Romultra/pcb-robotic-hand/docs/media/board/board_angled2.jpg

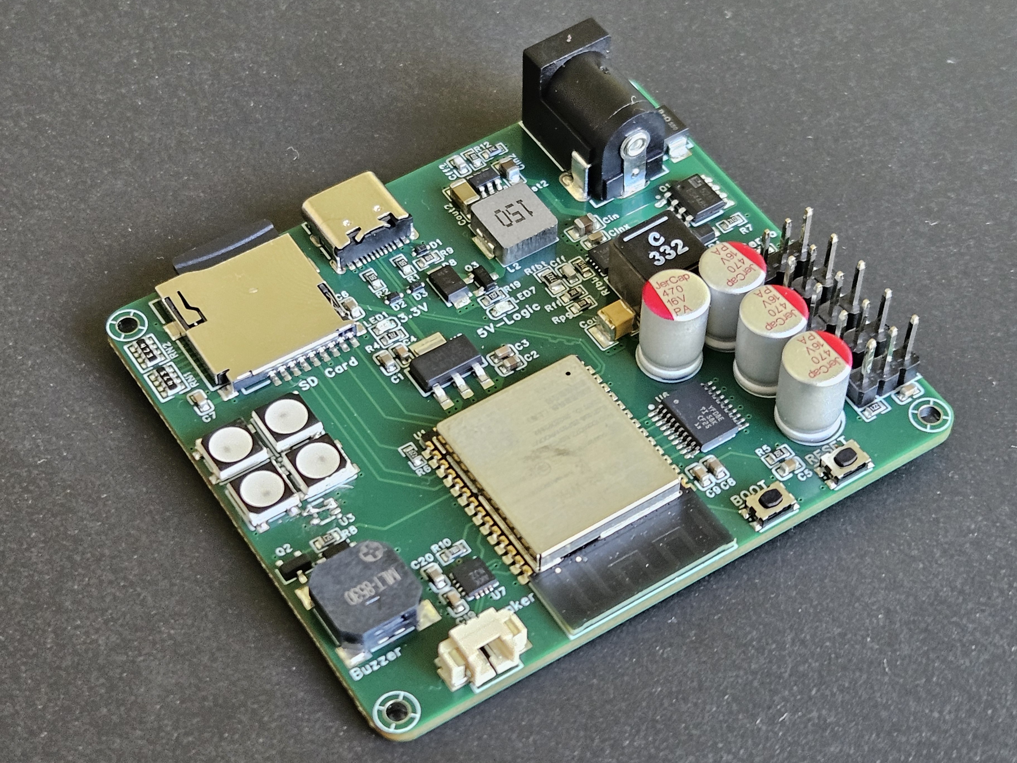
docs/media/board/board_angled2.jpg
