Romultra/pcb-robotic-hand/docs/media/board/board_scale.jpg

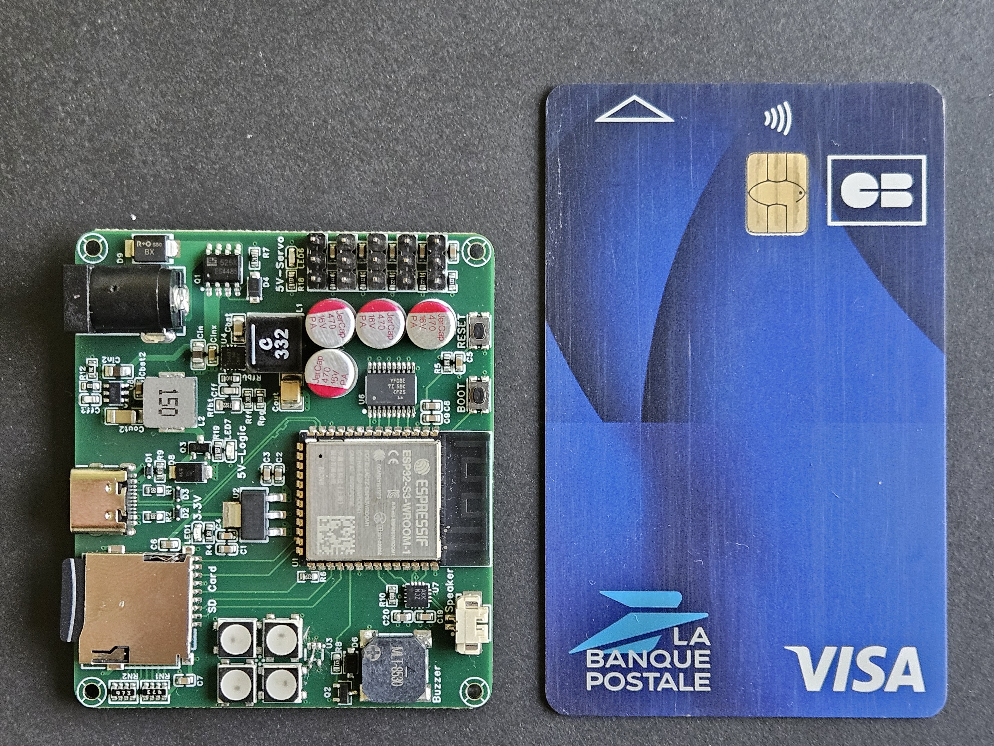
docs/media/board/board_scale.jpg
