Romultra/pcb-robotic-hand/docs/media/board/board_topdown.jpg

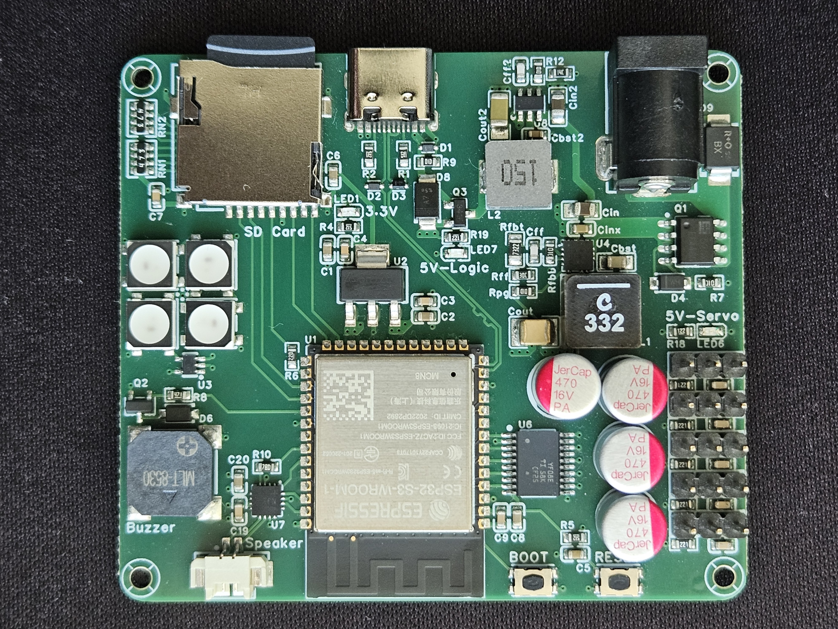
docs/media/board/board_topdown.jpg
