Romultra/pcb-robotic-hand/docs/media/demo/end_to_end_inset.jpg

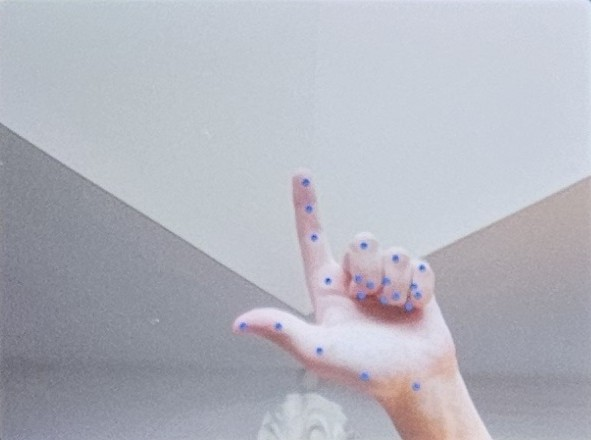
docs/media/demo/end_to_end_inset.jpg
