Romultra/pcb-robotic-hand/docs/media/prototype/prototype_arduino_shield.jpg

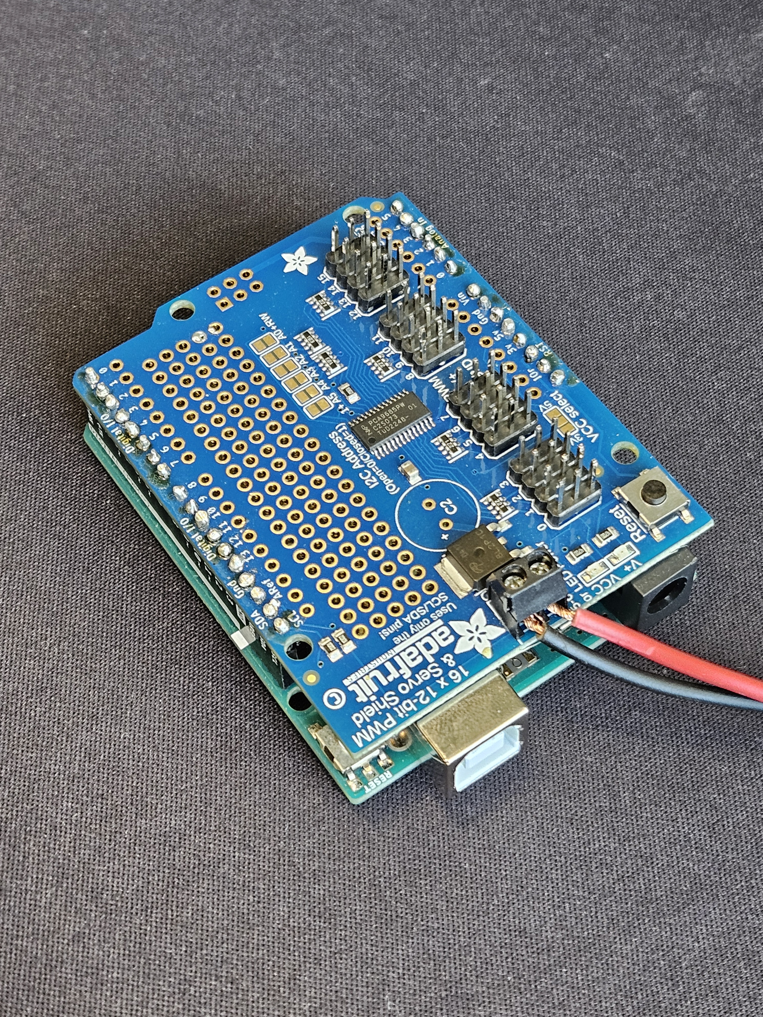
docs/media/prototype/prototype_arduino_shield.jpg
