Romultra/pcb-robotic-hand/docs/media/schematics/sch_audio.png

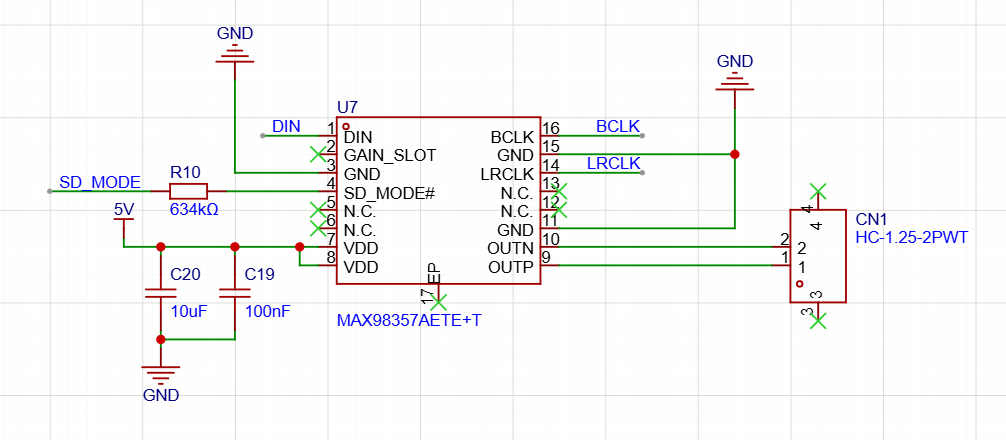
docs/media/schematics/sch_audio.png
