Romultra/pcb-robotic-hand/docs/media/schematics/sch_bootreset.png

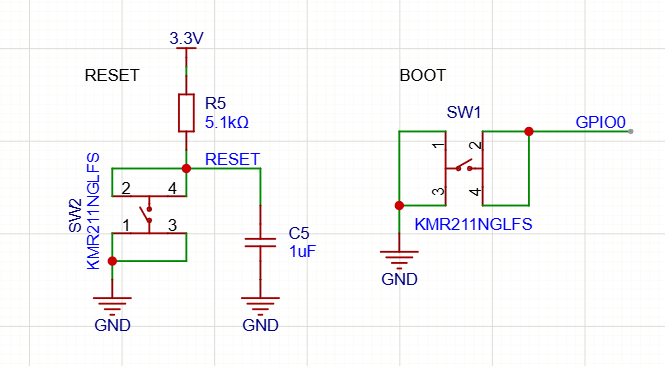
docs/media/schematics/sch_bootreset.png
