Romultra/pcb-robotic-hand/docs/media/schematics/sch_bucks.png

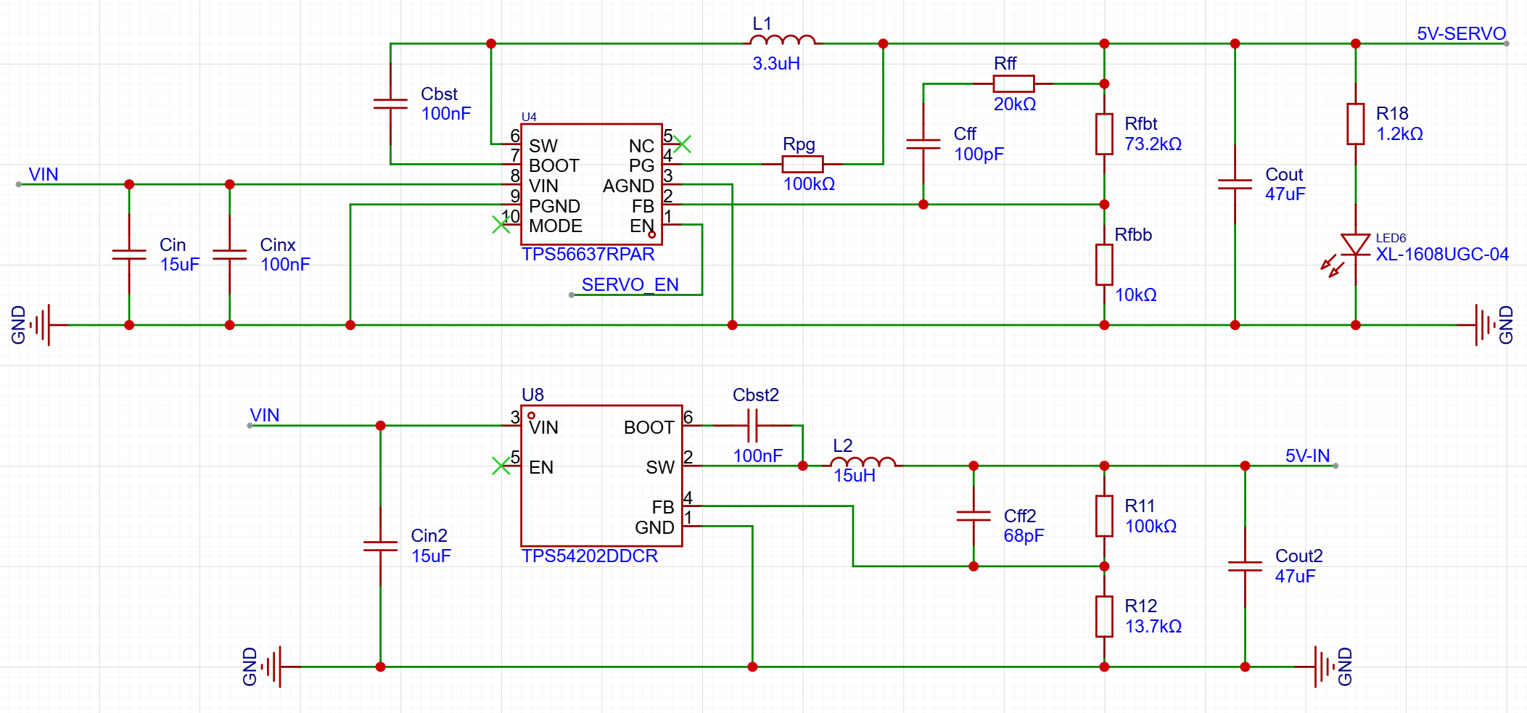
docs/media/schematics/sch_bucks.png
