Romultra/pcb-robotic-hand/docs/media/schematics/sch_esp32_core.png

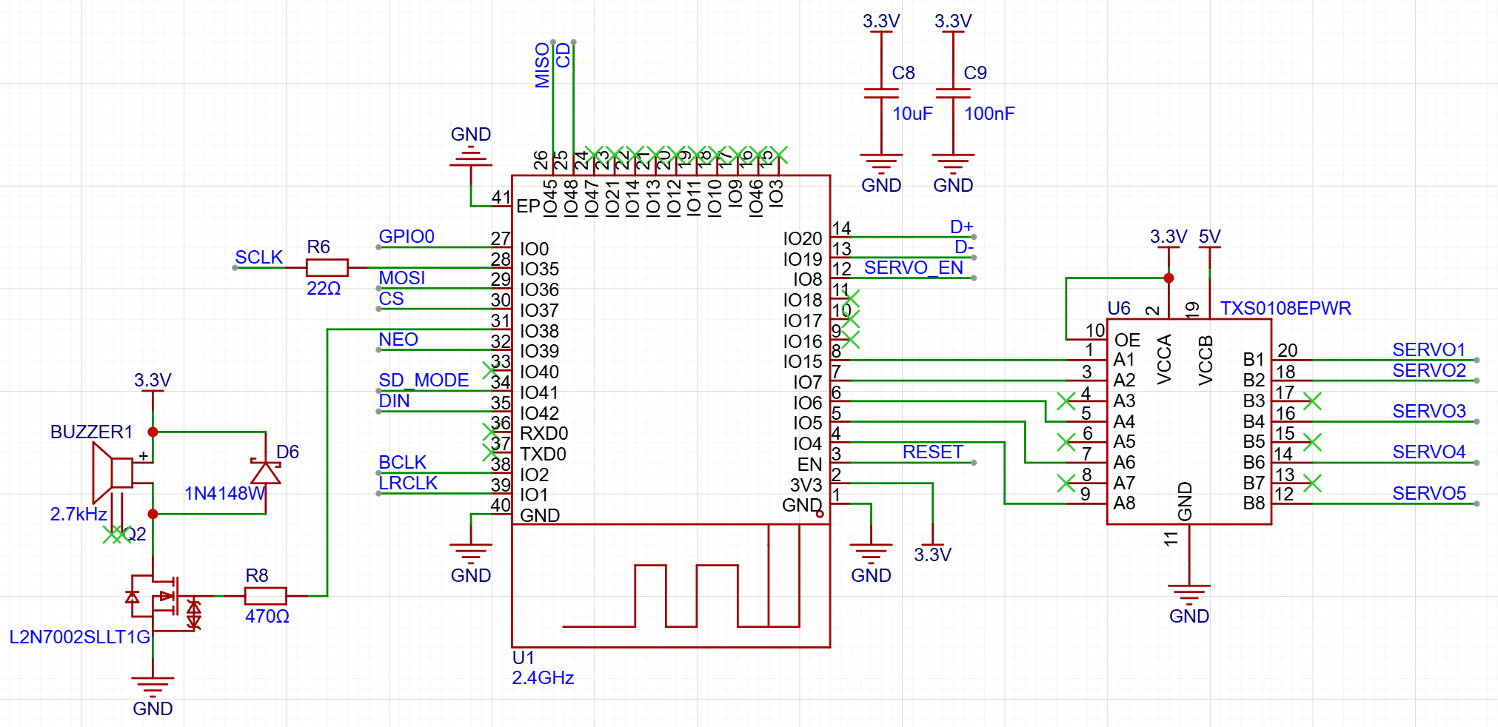
docs/media/schematics/sch_esp32_core.png
