Romultra/pcb-robotic-hand/docs/media/schematics/sch_leds.png

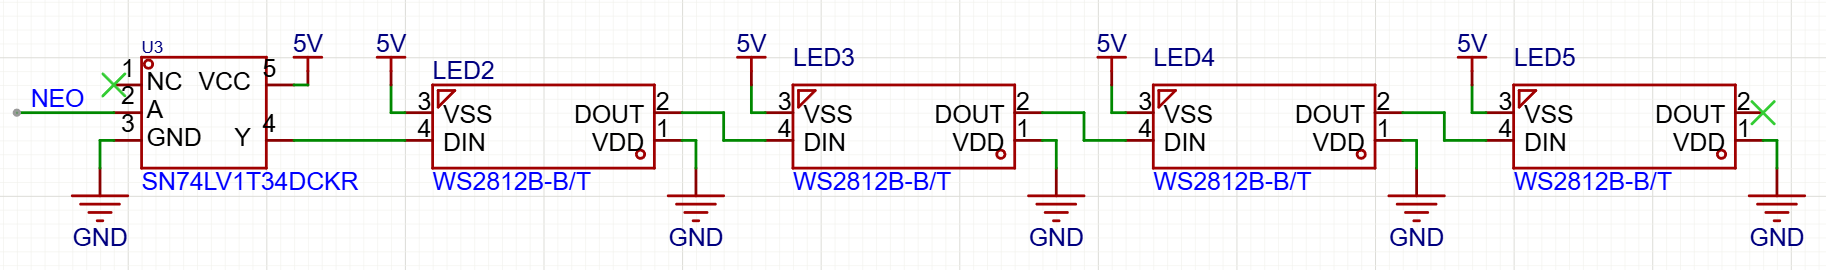
docs/media/schematics/sch_leds.png
