Romultra/pcb-robotic-hand/docs/media/schematics/sch_poweror_ldo.png

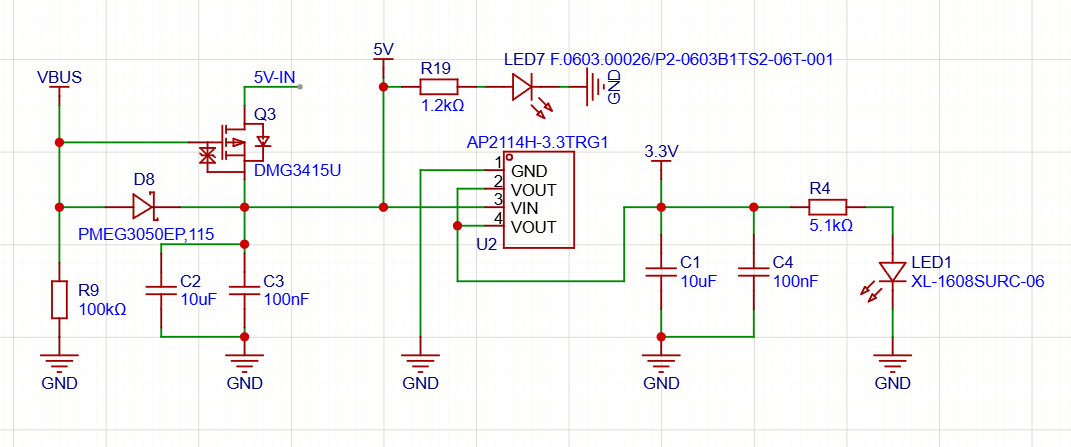
docs/media/schematics/sch_poweror_ldo.png
