Romultra/pcb-robotic-hand/docs/media/schematics/sch_revpol.png

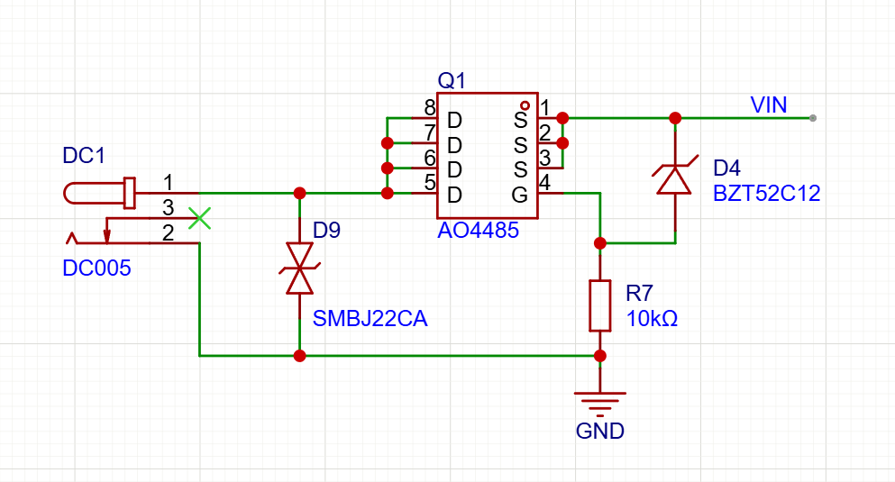
docs/media/schematics/sch_revpol.png
