Romultra/pcb-robotic-hand/docs/media/schematics/sch_sdcard.png

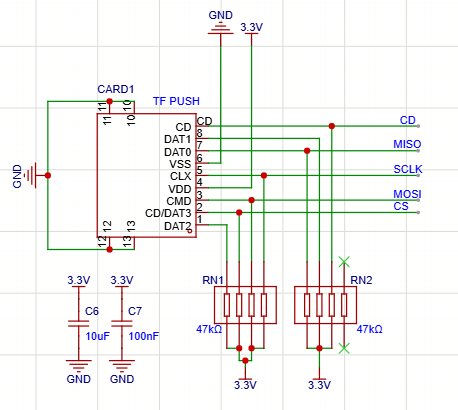
docs/media/schematics/sch_sdcard.png
