Romultra/pcb-robotic-hand/docs/media/schematics/sch_servo.png

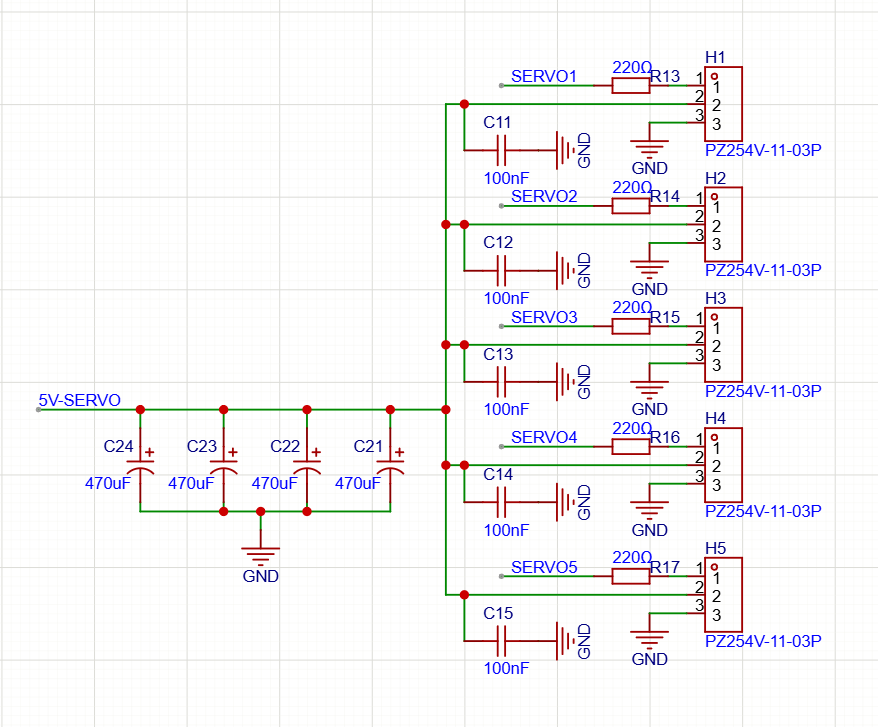
docs/media/schematics/sch_servo.png
