Romultra/pcb-robotic-hand/docs/media/schematics/sch_usbc.png

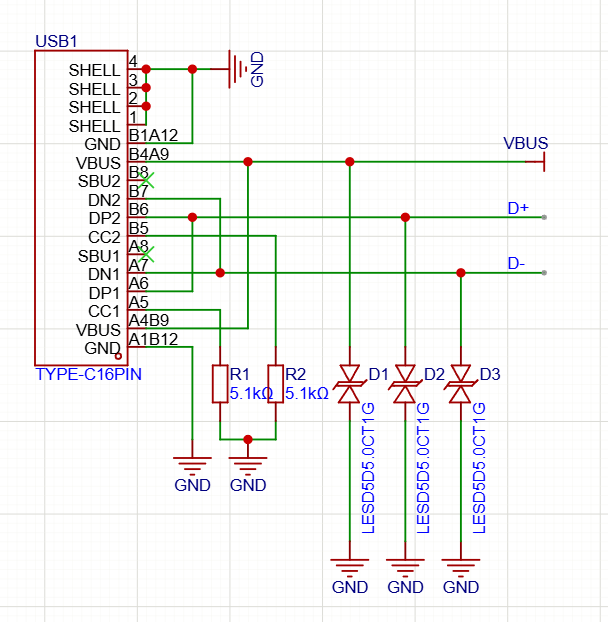
docs/media/schematics/sch_usbc.png
