Romultra/pcb-robotic-hand/docs/media/scope/servo_pwm_10deg_meas.png

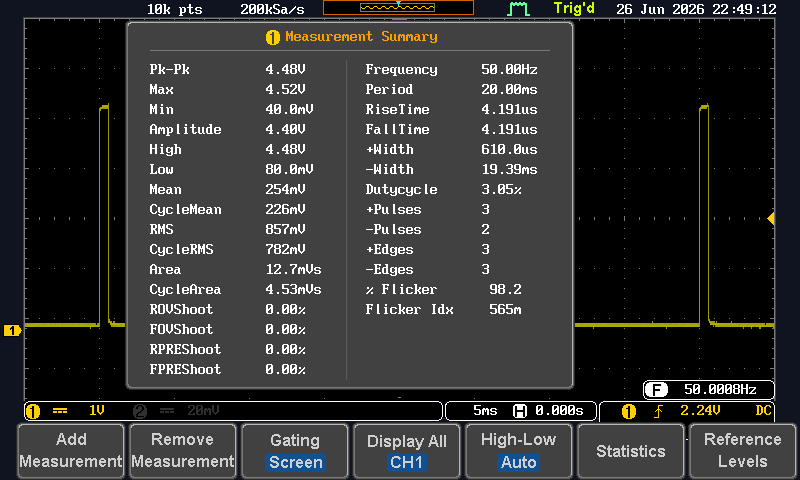
docs/media/scope/servo_pwm_10deg_meas.png
