Romultra/pcb-robotic-hand/docs/media/scope/servo_pwm_10deg_wave.png

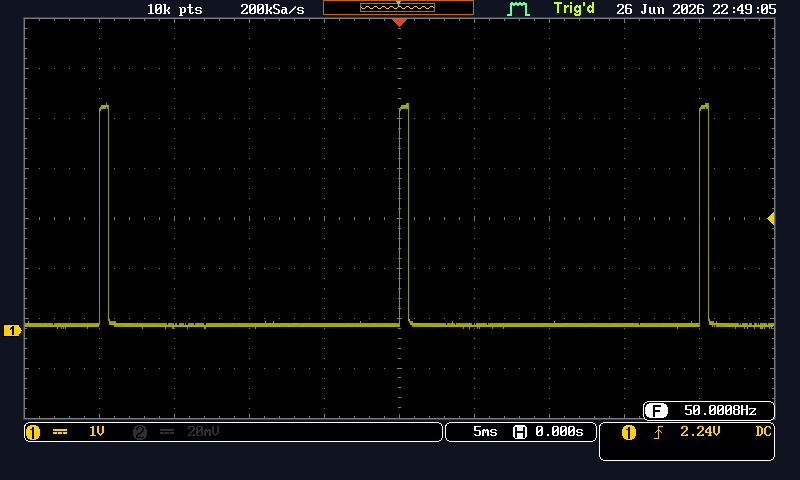
docs/media/scope/servo_pwm_10deg_wave.png
