Romultra/pcb-robotic-hand/docs/media/webapp/webapp_latency.jpg

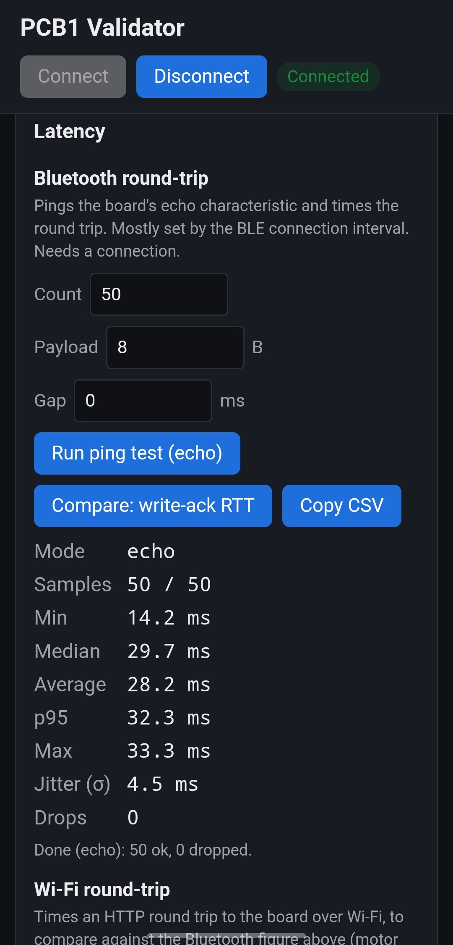
docs/media/webapp/webapp_latency.jpg
