Romultra/pcb-robotic-hand/docs/media/webapp/webapp_tracking.jpg

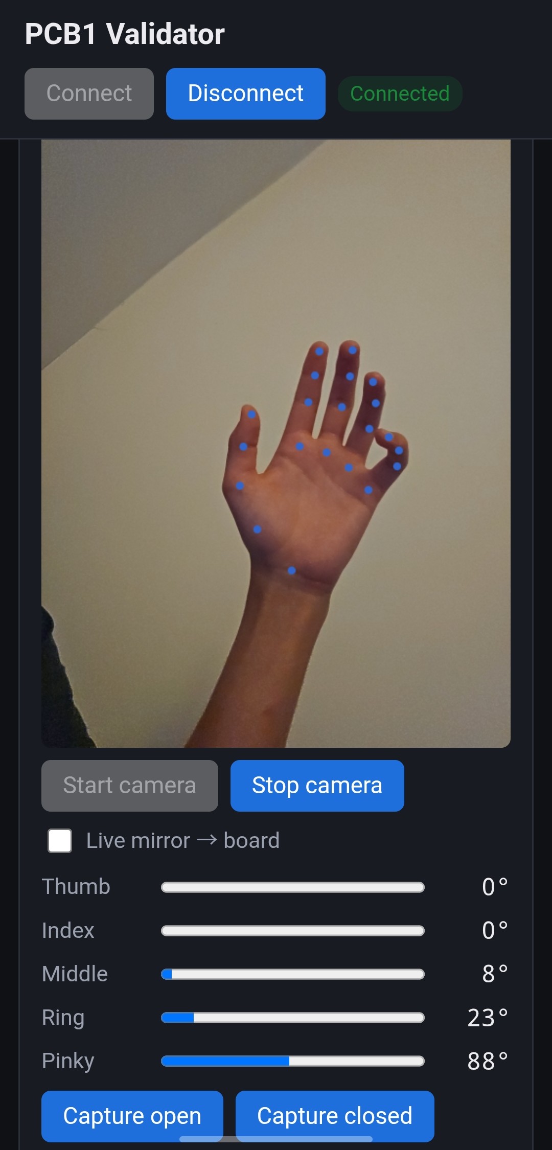
docs/media/webapp/webapp_tracking.jpg
