Romultra/pcb-robotic-hand/production/schematic snippets/Both Buck converters, 6A top, 2A bottom.png

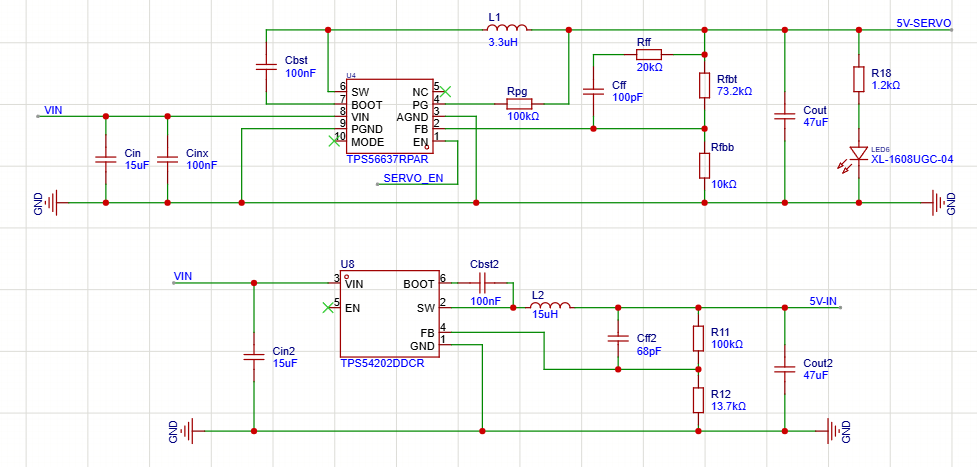
production/schematic snippets/Both Buck converters, 6A top, 2A bottom.png
