Romultra/pcb-robotic-hand/production/schematic snippets/ESP32 with level shifter on the right and buzzer circuit on the left.png

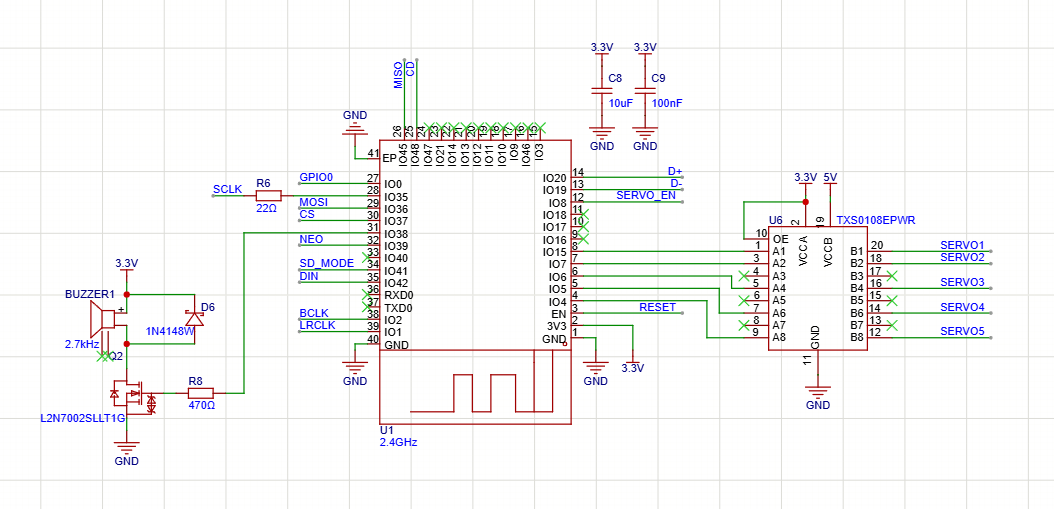
production/schematic snippets/ESP32 with level shifter on the right and buzzer circuit on the left.png
