Romultra/pcb-robotic-hand/production/schematic snippets/LEDs and level shifter, with flipped power pins.png

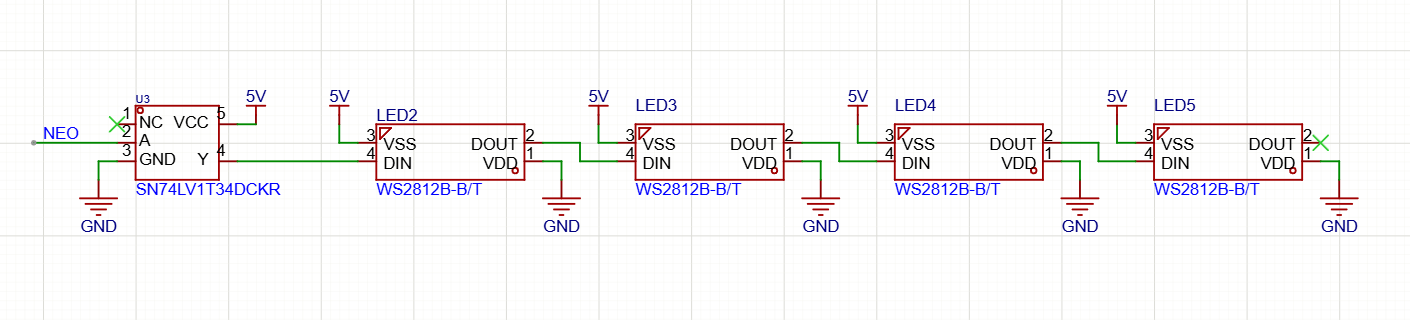
production/schematic snippets/LEDs and level shifter, with flipped power pins.png
