Romultra/pcb-robotic-hand/production/assembly-bom-order-2.xls

JLCPCB BOM Tool - BOM Matching
BOM name：f0bb450f1bc74c0686b73cc72776c1cf_1779839877000-JLCPCB Assembly Order.xlsx |  |  | Download Time：2026-06-26 00:54:33 |  |  |  | * Our matching results are updated in real-time, but stock and prices may change. If it's been over 24 hours, please re-match before placing your order.
PCB Assembled Qty：5 |  |  | Est. Total Price：44.4647
Your BOM |  |  |  |  | Matched Parts |  |  |  |  |  |  | Order Information
Top Designator | Bottom Designator | Comment | Footprint | JLCPCB Part # | Matches | Part # | Manufacturer | Footprint | Description | Category | Warning | JLCPCB Part # | Product link | Lib Type | Qty | Source | Total Price ($)
BUZZER1 |  | 2.7kHz | BUZ-SMD_4P-L8.5-W8.5-P8.50-BR |  | Select by System | MLT-8530 | Jiangsu Huaneng Elec | SMD,8.5x8.5mm | -20℃~+70℃ 2.5V~4.5V 2.7kHz 3.3mm 3.6V 8.5mm 8.5mm 80dB 95mA Electromagnetic Passive (Externally Driven) SMD SMD,8.5x8.5mm Buzzers ROHS | Buzzers |  | C94599 | https://jlcpcb.com/partdetail/Jiangsu_HuanengElec-MLT8530/C94599 | Extended | 2 | 2 JLCPCB | 0.41
C1,C2,C6,C8,C20 |  | 10uF | C0603 |  | Select by System | CL10A106KP8NNNC | Samsung Electro-Mechanics | 0603 | 10V 10uF X5R ±10% 0603 Multilayer Ceramic Capacitors MLCC - SMD/SMT ROHS | Multilayer Ceramic Capacitors MLCC - SMD/SMT |  | C19702 | https://jlcpcb.com/partdetail/20411-CL10A106KP8NNNC/C19702 | Basic | 20 | 20 JLCPCB | 1.104
C3,C4,C7,C9,C11,C12,C13,C14,C15,C19 |  | 100nF | C0603 |  | Select by System | CC0603KRX7R9BB104 | YAGEO | 0603 | 100nF 50V X7R ±10% 0603 Multilayer Ceramic Capacitors MLCC - SMD/SMT ROHS | Multilayer Ceramic Capacitors MLCC - SMD/SMT |  | C14663 | https://jlcpcb.com/partdetail/YAGEO-CC0603KRX7R9BB104/C14663 | Basic | 30 | 30 JLCPCB | 0.324
C5 |  | 1uF | C0603 |  | Select by System | CL10A105KB8NNNC | Samsung Electro-Mechanics | 0603 | 1uF 50V X5R ±10% 0603 Multilayer Ceramic Capacitors MLCC - SMD/SMT ROHS | Multilayer Ceramic Capacitors MLCC - SMD/SMT |  | C15849 | https://jlcpcb.com/partdetail/16531-CL10A105KB8NNNC/C15849 | Basic | 20 | 20 JLCPCB | 0.252
C21,C22,C23,C24 |  | 470uF | CAP-TH_BD6.3-P2.50-D0.6-FD-1 |  | Select by System | PA16V470M6X9 | jieerrui | 插件,D6.3xL9mm | -55℃~+105℃ 16V 16mΩ@100kHz 2.5mm 2000hrs@105℃ 4.1A@100kHz 470uF 6.3mm 9mm Polymer ±20% Plugin,D6.3xL9mm Polymer Aluminum Capacitors ROHS | Polymer Aluminum Capacitors |  | C48935355 | https://jlcpcb.com/partdetail/jieerrui-PA16V470M6X9/C48935355 | Extended | 8 | 8 JLCPCB | 1.172
CARD1 |  | TFPUSH | TF-SMD_TF-PUSH |  | Select by System | TF PUSH | SHOU HAN | SMD | -25℃~+90℃ 2mm Connector and Ejector MicroSD Card (TF Card) No Push-Push SMD SD Card / Memory Card Connector ROHS | SD Card / Memory Card Connector |  | C393941 | https://jlcpcb.com/partdetail/SHOUHAN-TFPUSH/C393941 | Extended | 2 | 2 JLCPCB | 0.1302
CBST |  | 100nF | C0805 |  | Select by System | CC0805KRX7R8BB104 | YAGEO | 0805 | 100nF 25V X7R ±10% 0805 Multilayer Ceramic Capacitors MLCC - SMD/SMT ROHS | Multilayer Ceramic Capacitors MLCC - SMD/SMT |  | C519981 | https://jlcpcb.com/partdetail/YAGEO-CC0805KRX7R8BB104/C519981 | Extended | 20 | 20 JLCPCB | 0.212
CBST2 |  | 100nF | C0603 |  | Select by System | CGA0603X7R104K500JT | HRE | 0603 | 100nF 50V X7R ±10% 0603 Multilayer Ceramic Capacitors MLCC - SMD/SMT ROHS | Multilayer Ceramic Capacitors MLCC - SMD/SMT |  | C6119867 | https://jlcpcb.com/partdetail/HRE-CGA0603X7R104K500JT/C6119867 | Extended | 20 | 20 JLCPCB | 0.294
CFF |  | 100pF | C0603 |  | Select by System | CC0603JRNPO6BN101 | YAGEO | 0603 | 100pF 10V NP0 ±5% 0603 Multilayer Ceramic Capacitors MLCC - SMD/SMT ROHS | Multilayer Ceramic Capacitors MLCC - SMD/SMT |  | C1853160 | https://jlcpcb.com/partdetail/YAGEO-CC0603JRNPO6BN101/C1853160 | Extended | 20 | 20 JLCPCB | 0.09
CFF2 |  | 68pF | C0603 |  | Select by System | CC0603JRNPO9BN680 | YAGEO | 0603 | 50V 68pF NP0 ±5% 0603 Multilayer Ceramic Capacitors MLCC - SMD/SMT ROHS | Multilayer Ceramic Capacitors MLCC - SMD/SMT |  | C62782 | https://jlcpcb.com/partdetail/YAGEO-CC0603JRNPO9BN680/C62782 | Extended | 20 | 20 JLCPCB | 0.092
CIN,CIN2 |  | 15uF | C0805 |  | Select by System | C2012X5R1V156MT000E | TDK | 0805 | 15uF 35V X5R ±20% 0805 Multilayer Ceramic Capacitors MLCC - SMD/SMT ROHS | Multilayer Ceramic Capacitors MLCC - SMD/SMT |  | C5367448 | https://jlcpcb.com/partdetail/TDK-C2012X5R1V156MT000E/C5367448 | Extended | 6 | 6 JLCPCB | 1.9356
CINX |  | 100nF | C0603 |  | Select by System | GRM188R72A104KA35D | Murata Electronics | 0603 | 100V 100nF X7R ±10% 0603 Multilayer Ceramic Capacitors MLCC - SMD/SMT ROHS | Multilayer Ceramic Capacitors MLCC - SMD/SMT |  | C77058 | https://jlcpcb.com/partdetail/MurataElectronics-GRM188R72A104KA35D/C77058 | Extended | 20 | 20 JLCPCB | 0.68
CN1 |  | HC-1.25-2PWT | CONN-SMD_2P-P1.25-HC-1.25-2PWT |  | Select by System | HC-1.25-2PWT | HCTL | SMD,P=1.25mm,卧贴 | -40℃~+105℃ 1 1.25mm 125V 1A 1x2P 2 2P 3.57mm 5.25mm 7.55mm Auxiliary Solder Pin Brass LCP PicoBlade(MX 1.25) Surface Mount, Right Angle Tin UL94V-0 SMD,P=1.25mm,卧贴 Wire To Board Connector ROHS | Wire To Board Connector |  | C2845379 | https://jlcpcb.com/partdetail/HCTL-HC_1_252PWT/C2845379 | Extended | 6 | 6 JLCPCB | 0.3012
COUT |  | 47uF | C1210 |  | Select by System | GRM32ER61C476KE15L | Murata Electronics | 1210 | 16V 47uF X5R ±10% 1210 Multilayer Ceramic Capacitors MLCC - SMD/SMT ROHS | Multilayer Ceramic Capacitors MLCC - SMD/SMT |  | C77101 | https://jlcpcb.com/partdetail/MurataElectronics-GRM32ER61C476KE15L/C77101 | Extended | 5 | 5 JLCPCB | 1.481
COUT2 |  | 47uF | C1206 |  | Select by System | EMK316BBJ476ML-T | Taiyo Yuden | 1206 | 16V 47uF X5R ±20% 1206 Multilayer Ceramic Capacitors MLCC - SMD/SMT ROHS | Multilayer Ceramic Capacitors MLCC - SMD/SMT |  | C385907 | https://jlcpcb.com/partdetail/TaiyoYuden-EMK316BBJ476MLT/C385907 | Extended | 5 | 5 JLCPCB | 1.3215
D1,D2,D3 |  | LESD5D5.0CT1G | SOD-523_L1.2-W0.8-LS1.6-BI |  | Select by System | LESD5D5.0CT1G(UMW) | UMW(Youtai Semiconductor Co., Ltd.) | SOD-523 | -40℃~+125℃ 15pF 18.6V 1uA 5V 7.8V 9.4A@8/20us IEC 61000-4-2、IEC 61000-4-4 TVS SOD-523 ESD and Surge Protection (TVS/ESD) ROHS | ESD And Surge Protection (TVS/ESD) |  | C5199850 | https://jlcpcb.com/partdetail/5885882-LESD5D5_0CT1G_UMW/C5199850 | Extended | 20 | 20 JLCPCB | 0.286
D4 |  | BZT52C12 | SOD-123_L2.7-W1.6-LS3.7-RD |  | Select by System | BZT52C12 | MDD(Microdiode Semiconductor) | SOD-123 | 1 Independent 100nA@9V 11.4V~12.6V 12V 35Ω 500mW SOD-123 Zener Diodes ROHS | Zener Diodes |  | C173429 | https://jlcpcb.com/partdetail/184818-BZT52C12/C173429 | Extended | 15 | 15 JLCPCB | 0.213
D6 |  | 1N4148W | SOD-123_L2.7-W1.6-LS3.7-FD |  | Select by System | 1N4148W | hongjiacheng | SOD-123 | -55℃~+150℃ 1.25V@150mA 100V 150mA 1uA@75V 2A 400mW 4ns Independent SOD-123 Switching Diodes ROHS | Switching Diodes |  | C7420318 | https://jlcpcb.com/partdetail/hongjiacheng-1N4148W/C7420318 | Extended | 15 | 15 JLCPCB | 0.084
D8 |  | PMEG3050EP,115 | SOD-128_L3.7-W2.5-LS4.7-RD |  | Select by System | PMEG3050EP,115 | Nexperia | SOD-128 | 1 Independent 30V 360mV@5A 5A 70A 8mA@30V SOD-128 Schottky Diodes ROHS | Global Sourcing Parts |  | C50603 | https://jlcpcb.com/partdetail/Nexperia-PMEG3050EP115/C50603 | Extended | 5 | 5 JLCPCB | 2.5485
D9 |  | SMBJ22CA | SMB_L4.6-W3.6-LS5.4-BI |  | Select by System | SMBJ22CA | hongjiacheng | DO-214AA(SMB) | -55℃~+150℃ 16.9A@10/1000us 22V 26.9V 35.5V 5uA 600W@10/1000us Bidirectional IEC 61000-4-2 TVS DO-214AA(SMB) ESD and Surge Protection (TVS/ESD) ROHS | ESD And Surge Protection (TVS/ESD) |  | C19077577 | https://jlcpcb.com/partdetail/hongjiacheng-SMBJ22CA/C19077577 | Extended | 5 | 5 JLCPCB | 0.2445
DC1 |  | DC005 | DC-IN-TH_DC005 |  | Select by System | DC005 | SHOU HAN | 插件 | -30℃~+70℃ 12V 2mm 500mA 6.3mm DC Power Jack Right Angle 插件 DC Power Connectors ROHS | DC Power Connectors |  | C431533 | https://jlcpcb.com/partdetail/SHOUHAN-DC005/C431533 | Extended | 3 | 3 JLCPCB | 0.1608
H1,H2,H3,H4,H5 |  | PZ254V-11-03P | HDR-TH_3P-P2.54-V-M_PZ254V-11-03P |  | Select by System | PZ254V-11-03P | XFCN | 插件,P=2.54mm | -40℃~+105℃ 1 1x3P 2.54mm 2.5mm 250V 3A 3P 3mm 6mm Black Pin Header Through Hole Plugin,P=2.54mm Pin Headers ROHS | Pin Headers |  | C2937625 | https://jlcpcb.com/partdetail/XFCN-PZ254V_1103P/C2937625 | Extended | 12 | 12 JLCPCB | 0.2316
L1 |  | 3.3uH | IND-SMD_L7.5-W7.2-1 |  | Select by System | XAL7070-332MEC | Coilcraft | SMD,7.2x7.5mm | 15.1A 19.4A 3.3uH 9.42mΩ AEC-Q200 Magnetic Shielded Inductor ±20% SMD,7.2x7.5mm Power Inductors ROHS | Power Inductors |  | C3911435 | https://jlcpcb.com/partdetail/Coilcraft-XAL7070332MEC/C3911435 | Extended | 2 | 2 JLCPCB | 6.3592
L2 |  | 15uH | IND-SMD_L7.1-W6.6 |  | Select by System | APH0630T150M | APV | SMD,7x6.6mm | 113mΩ 15uH 3A 4A Molded Inductor ±20% SMD,7x6.6mm Power Inductors ROHS | Power Inductors |  | C5349699 | https://jlcpcb.com/partdetail/APV-APH0630T150M/C5349699 | Extended | 5 | 5 JLCPCB | 0.413
LED1 |  | XL-1608SURC-06 | LED0603-RD_RED |  | Select by System | XL-1608SURC-06 | XINGLIGHT | 0603 | -40℃~+85℃ 120° 2.3V 20mA 225mcd 50mW 620nm~630nm 625nm Discrete Diode Red Top-mount Water Clear 0603 LED Indication - Discrete ROHS | LED Indication - Discrete |  | C965799 | https://jlcpcb.com/partdetail/XINGLIGHT-XL_1608SURC06/C965799 | Extended | 20 | 20 JLCPCB | 0.076
LED2,LED3,LED4,LED5 |  | WS2812B-B/T | LED-SMD_4P-L5.0-W5.0-TL_WS2812B-B |  | Select by System | WS2812B-B/T | Worldsemi | SMD5050-4P | 0.6mA 1.57mm 2kHz 3.7V~5.3V 5.4mm 5mm 800Kbit/s Built-in power-on reset circuit、Built-in power-on reset circuit、Built-in one-way transmission function G:520nm、B:471nm、R:621nm G:520nm、B:471nm、R:621nm G:600mcd~1000mcd、B:200mcd~300mcd、R:300mcd~500mcd SMD5050-4P RGB LEDs(Built-in IC) ROHS | RGB LEDs(Built-In IC) |  | C2761795 | https://jlcpcb.com/partdetail/Worldsemi-WS2812B_BT/C2761795 | Extended | 9 | 9 JLCPCB | 0.9477
LED6 |  | XL-1608UGC-04 | LED0603-RD_GREEN |  | Select by System | XL-1608UGC-04 | XINGLIGHT | 0603 | -40℃~+85℃ 120° 20mA 3.3V 515nm~535nm 525nm 70mW 810mcd Discrete Diode Emerald Green Top-mount Water Clear 0603 LED Indication - Discrete ROHS | LED Indication - Discrete |  | C965804 | https://jlcpcb.com/partdetail/XINGLIGHT-XL_1608UGC04/C965804 | Extended | 20 | 20 JLCPCB | 0.098
LED7 |  | F.0603.00026/P2-0603B1TS2-06T-001 | LED0603-RD |  | Select by System | F.0603.00026/P2-0603B1TS2-06T-001 | TUOZHAN | 0603 | -40℃~+85℃ 120° 2.5V~2.9V 460nm~465nm 462nm 5mA 60mcd 90mW Blue Discrete Diode 0603 LED Indication - Discrete ROHS | LED Indication - Discrete |  | C7496819 | https://jlcpcb.com/partdetail/C7496819 | Extended | 20 | 20 JLCPCB | 0.088
Q1 |  | AO4485 | SOP-8_L5.1-W3.9-P1.27-LS6.0-BL |  | Select by System | AO4485 | ElecSuper | SOP8 | -55℃~+150℃ 1 P-Channel 1.6V 11A 13mΩ@10V、17mΩ@4.5V 180pF 2.5nF 260pF 3.2W 40V 42nC@10V P-Channel SOP8 MOSFETs ROHS | MOSFETs |  | C5334068 | https://jlcpcb.com/partdetail/ElecSuper-AO4485/C5334068 | Extended | 2 | 2 JLCPCB | 0.5002
Q2 |  | L2N7002SLLT1G | SOT-23-3_L3.0-W1.7-P0.95-LS2.9-BR |  | Select by System | L2N7002SLLT1G | LRC | SOT-23 | -55℃~+150℃ 1 N-channel 10pF 1V 2.8Ω@10V 35pF 380mA 420mW 440pC@4.5V 60V N-Channel SOT-23 MOSFETs ROHS | MOSFETs |  | C22446827 | https://jlcpcb.com/partdetail/LRC-L2N7002SLLT1G/C22446827 | Extended | 10 | 10 JLCPCB | 0.063
Q3 |  | DMG3415U | SOT-23-3_L2.9-W1.3-P1.90-LS2.4-BR-1 |  | Select by System | DMG3415U | TECH PUBLIC | SOT-23 | -55℃~+150℃ 1 P-Channel 1.1811nF 1.4W 10.2nC@4.5V 114.8pF 121.3pF 20V 350mV 49mΩ@2.5V 4A SOT-23 MOSFETs ROHS | MOSFETs |  | C7202986 | https://jlcpcb.com/partdetail/TECHPUBLIC-DMG3415U/C7202986 | Extended | 6 | 6 JLCPCB | 0.3378
R1,R2,R4,R5 |  | 5.1kΩ | R0603 |  | Select by System | 0603WAF5101T5E | UNI-ROYAL(Uniroyal Elec) | 0603 | -55℃~+155℃ 100mW 5.1kΩ 75V Thick Film Resistor ±1% ±100ppm/℃ 0603 Chip Resistor - Surface Mount ROHS | Chip Resistor - Surface Mount |  | C23186 | https://jlcpcb.com/partdetail/23913-0603WAF5101T5E/C23186 | Basic | 20 | 20 JLCPCB | 0.046
R6 |  | 22Ω | R0603 |  | Select by System | 0603WAF220JT5E | UNI-ROYAL(Uniroyal Elec) | 0603 | -55℃~+155℃ 100mW 22Ω 75V Thick Film Resistor ±1% ±100ppm/℃ 0603 Chip Resistor - Surface Mount ROHS | Chip Resistor - Surface Mount |  | C23345 | https://jlcpcb.com/partdetail/24078-0603WAF220JT5E/C23345 | Basic | 20 | 20 JLCPCB | 0.044
R8 |  | 470Ω | R0603 |  | Select by System | 0603WAF4700T5E | UNI-ROYAL(Uniroyal Elec) | 0603 | -55℃~+155℃ 100mW 470Ω 75V Thick Film Resistor ±1% ±100ppm/℃ 0603 Chip Resistor - Surface Mount ROHS | Chip Resistor - Surface Mount |  | C23179 | https://jlcpcb.com/partdetail/23906-0603WAF4700T5E/C23179 | Basic | 20 | 20 JLCPCB | 0.04
R9,R11,RPG |  | 100kΩ | R0603 |  | Select by System | 0603WAF1003T5E | UNI-ROYAL(Uniroyal Elec) | 0603 | -55℃~+155℃ 100kΩ 100mW 75V Thick Film Resistor ±1% ±100ppm/℃ 0603 Chip Resistor - Surface Mount ROHS | Chip Resistor - Surface Mount |  | C25803 | https://jlcpcb.com/partdetail/26546-0603WAF1003T5E/C25803 | Basic | 20 | 20 JLCPCB | 0.044
R10 |  | 634kΩ | R0603 |  | Select by System | 0603WAF6343T5E | UNI-ROYAL(Uniroyal Elec) | 0603 | -55℃~+155℃ 100mW 634kΩ 75V Thick Film Resistor ±1% ±100ppm/℃ 0603 Chip Resistor - Surface Mount ROHS | Chip Resistor - Surface Mount |  | C65831 | https://jlcpcb.com/partdetail/66907-0603WAF6343T5E/C65831 | Extended | 20 | 20 JLCPCB | 0.026
R12 |  | 13.7kΩ | R0603 |  | Select by System | 0603WAF1372T5E | UNI-ROYAL(Uniroyal Elec) | 0603 | -55℃~+155℃ 100mW 13.7kΩ 75V Thick Film Resistor ±1% ±100ppm/℃ 0603 Chip Resistor - Surface Mount ROHS | Chip Resistor - Surface Mount |  | C22793 | https://jlcpcb.com/partdetail/23520-0603WAF1372T5E/C22793 | Extended | 20 | 20 JLCPCB | 0.05
R13,R14,R15,R16,R17 |  | 220Ω | R0603 |  | Select by System | FRC0603J221 TS | FOJAN | 0603 | -55℃~+155℃ 100mW 220Ω 75V Thick Film Resistor ±100ppm/℃ ±5% 0603 Chip Resistor - Surface Mount ROHS | Chip Resistor - Surface Mount |  | C2907127 | https://jlcpcb.com/partdetail/FOJAN-FRC0603J221TS/C2907127 | Extended | 20 | 20 JLCPCB | 0.034
R18,R19 |  | 1.2kΩ | R0603 |  | Select by System | FRC0603F1201TS | FOJAN | 0603 | -55℃~+155℃ 1.2kΩ 100mW 75V Thick Film Resistor ±1% ±100ppm/℃ 0603 Chip Resistor - Surface Mount ROHS | Chip Resistor - Surface Mount |  | C2906976 | https://jlcpcb.com/partdetail/FOJAN-FRC0603F1201TS/C2906976 | Extended | 20 | 20 JLCPCB | 0.044
RFBT |  | 73.2kΩ | R0805 |  | Select by System | 0805W8F7322T5E | UNI-ROYAL(Uniroyal Elec) | 0805 | -55℃~+155℃ 125mW 150V 73.2kΩ Thick Film Resistor ±1% ±100ppm/℃ 0805 Chip Resistor - Surface Mount ROHS | Chip Resistor - Surface Mount |  | C17814 | https://jlcpcb.com/partdetail/18502-0805W8F7322T5E/C17814 | Extended | 20 | 20 JLCPCB | 0.046
RFF |  | 20kΩ | R0603 |  | Select by System | 0603WAF2002T5E | UNI-ROYAL(Uniroyal Elec) | 0603 | -55℃~+155℃ 100mW 20kΩ 75V Thick Film Resistor ±1% ±100ppm/℃ 0603 Chip Resistor - Surface Mount ROHS | Chip Resistor - Surface Mount |  | C4184 | https://jlcpcb.com/partdetail/4591-0603WAF2002T5E/C4184 | Basic | 20 | 20 JLCPCB | 0.042
RN1,RN2 |  | 47kΩ | RES-ARRAY-SMD_0603-8P-L3.2-W1.6-BL |  | Select by System | RTA03-4D473JTP | RALEC | 0603x4 | 1/16W 4 47kΩ 8 ±200ppm/℃ ±5% 0603x4 Resistor Networks, Arrays ROHS | Resistor Networks, Arrays |  | C102673 | https://jlcpcb.com/partdetail/RALEC-RTA034D473JTP/C102673 | Extended | 4 | 4 JLCPCB | 0.024
SW1,SW2 |  | KMR211NGLFS | SW-SMD_4P-L4.2-W2.8-P1.60-LS4.6-TR |  | Select by System | KMR211NGLFS | C&K | SMD | -40℃~+85℃ 1.2N 1.9mm 2.8mm 32V 4.6mm 50mA Gull Wing Round Button SPST-NO Surface Mount,Vertical SMD Tactile Switches ROHS | Tactile Switches |  | C221676 | https://jlcpcb.com/partdetail/CK-KMR211NGLFS/C221676 | Extended | 5 | 5 JLCPCB | 3.1335
U1 |  | 2.4GHz | WIFIM-SMD_ESP32-S3-WROOM-1-N8 |  | Select by System | ESP32-S3-WROOM-1-N8 | Espressif Systems | SMD,25.5x18mm | -40℃~+85℃ -98.2dBm 2.4GHz 20.5dBm 355mA 3V~3.6V 95mA Bluetooth5.0 ESP32-S3 Chip On-board PCB Antenna UART、SPI、I2C、I2S、USB SMD,25.5x18mm WiFi Modules ROHS | WiFi Modules |  | C2913198 | https://jlcpcb.com/partdetail/3198296-ESP32_S3_WROOM_1N8/C2913198 | Extended | 2 | 2 JLCPCB | 9.5452
U2 |  | AP2114H-3.3TRG1 | SOT-223_L6.7-W3.5-P2.30-BR |  | Select by System | AP2114H-3.3TRG1 | Diodes Incorporated | SOT-223 | -40℃~+85℃@(Ta) 1 1A 3.3V 30uVrms 450mV@(1A) 65dB@(1kHz) 65uA 6V Fixed Over Current Protection、Over Temperature Protection Positive SOT-223 Voltage Regulators - Linear, Low Drop Out (LDO) Regulators ROHS | Voltage Regulators - Linear, Low Drop Out (LDO) Regulators |  | C150716 | https://jlcpcb.com/partdetail/DiodesIncorporated-AP2114H_33TRG1/C150716 | Extended | 4 | 4 JLCPCB | 0.7712
U3 |  | SN74LV1T34DCKR | SC-70-5_L2.1-W1.3-P0.65-LS2.1-BR |  | Select by System | SN74LV1T34DCKR | Texas Instruments | SC-70-5 | -40℃~+125℃ 1 1 1.6V~5.5V 10uA 5.5ns@5V,15pF 74LV 8mA 8mA Push-pull Unidirectional SC-70-5 Buffers, Drivers, Receivers, Transceivers ROHS | Buffers, Drivers, Receivers, Transceivers |  | C78541 | https://jlcpcb.com/partdetail/TexasInstruments-SN74LV1T34DCKR/C78541 | Extended | 5 | 5 JLCPCB | 0.373
U4 |  | TPS56637RPAR | VQFN-HR-10_L3.0-W3.0_RPA |  | Select by System | TPS56637RPAR | Texas Instruments | VQFN-10-HR(3x3) | -40℃~+150℃@(TJ) 1 140uA 4.5V~28V 500kHz 600mV~13V 6A Adjustable Buck Buck Built-in Yes VQFN-10-HR(3x3) DC-DC Converters ROHS | DC-DC Converters |  | C841386 | https://jlcpcb.com/partdetail/TexasInstruments-TPS56637RPAR/C841386 | Extended | 2 | 2 JLCPCB | 3.0964
U6 |  | TXS0108EPWR | TSSOP-20_L6.5-W4.4-P0.65-LS6.4-BL |  | Select by System | TXS0108EPWR | Texas Instruments | TSSOP-20 | -40℃~+85℃ 1 1.4V~3.6V 1.65V~5.5V 60Mbps 8 Auto Direction Detection Bidirectional Push-Pull、Open-drain TSSOP-20 Translators, Level Shifters ROHS | Translators, Level Shifters |  | C17206 | https://jlcpcb.com/partdetail/TexasInstruments-TXS0108EPWR/C17206 | Extended | 2 | 2 JLCPCB | 0.7694
U7 |  | MAX98357AETE+T | TQFN-16_L3.0-W3.0-P0.50-BL-EP1.5 |  | Select by System | MAX98357AETE+T | Analog Devices Inc./Maxim Integrated | TQFN-16-EP(3x3) | -40℃~+85℃ 2.4mA 2.5V~5.5V 3.2Wx1@4Ω 77dB 92% Automatic mute/no-noise switch、Enable/disable function、Filterless architecture、Configurable output topology Class D TQFN-16-EP(3x3) Audio Amplifiers ROHS | Audio Amplifiers |  | C910544 | https://jlcpcb.com/partdetail/978950-MAX98357AETET/C910544 | Extended | 2 | 2 JLCPCB | 2.6348
U8 |  | TPS54202DDCR | SOT-23-6_L2.9-W1.6-P0.95-LS2.8-BL |  | Select by System | TPS54202DDCR | Texas Instruments | SOT-23-6 | -40℃~+125℃@(TJ) 1 2A 4.5V~28V 45uA 500kHz Adjustable Buck Buck Built-in Yes SOT-23-6 DC-DC Converters ROHS | DC-DC Converters |  | C191884 | https://jlcpcb.com/partdetail/TexasInstruments-TPS54202DDCR/C191884 | Extended | 5 | 5 JLCPCB | 1.115
USB1 |  | TYPE-C16PIN | USB-C-SMD_TYPE-C16PIN |  | Select by System | TYPE-C16PIN | SHOU HAN | SMD | -40℃~+85℃ 1 10,000 Cycles 16P 30V 3A Black Female Surface Mount, Right Angle Type-C SMD USB Connectors ROHS | USB Connectors |  | C393939 | https://jlcpcb.com/partdetail/SHOUHAN-TYPEC16PIN/C393939 | Extended | 2 | 2 JLCPCB | 0.1354
R7,RFBB |  | 10kΩ | R0603 |  | Select by System | 0603WAF1002T5E | UNI-ROYAL(Uniroyal Elec) | 0603 | -55℃~+155℃ 100mW 10kΩ 75V Thick Film Resistor ±1% ±100ppm/℃ 0603 Chip Resistor - Surface Mount ROHS | Chip Resistor - Surface Mount |  | C25804 | https://jlcpcb.com/partdetail/26547-0603WAF1002T5E/C25804 | Basic | 20 | 0 JLCPCB | 0.032
