Romultra/pcb-robotic-hand/docs/media/demo/test_bench.jpg

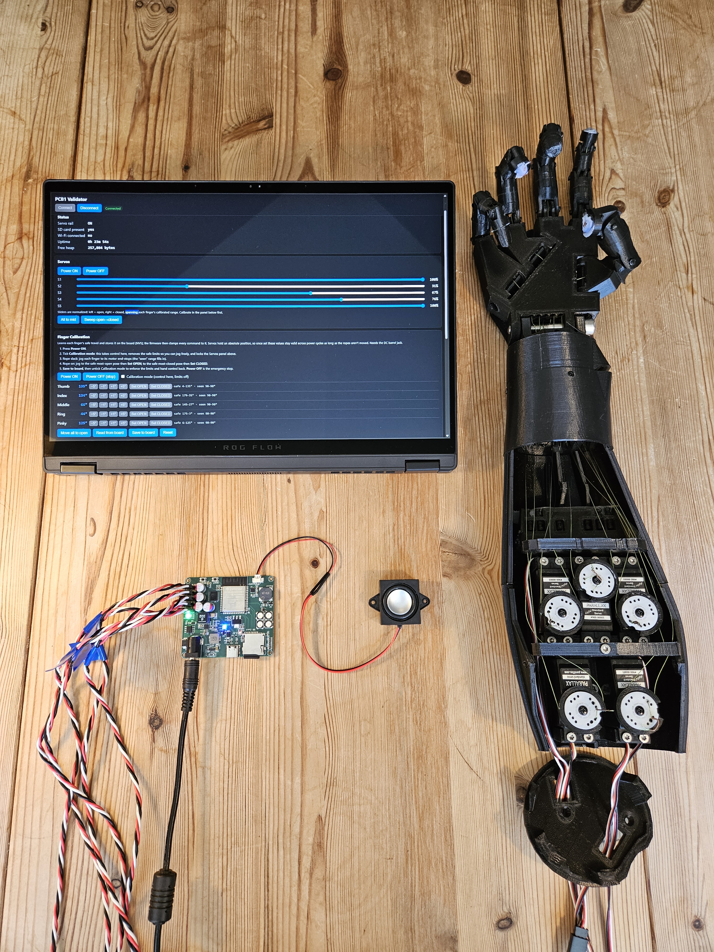
docs/media/demo/test_bench.jpg
