Romultra/pcb-robotic-hand/production/Schematic1.pdf

GND A1B12 VBUS A4B9 CC1 A5 DP1 A6 DN1 A7 SBU1 A8 CC2 B5 DP2 B6 DN2 B7 SBU2 B8 VBUS B4A9 GND B1A12 SHELL 1

## D1LESD⁵D⁵.0CT1G

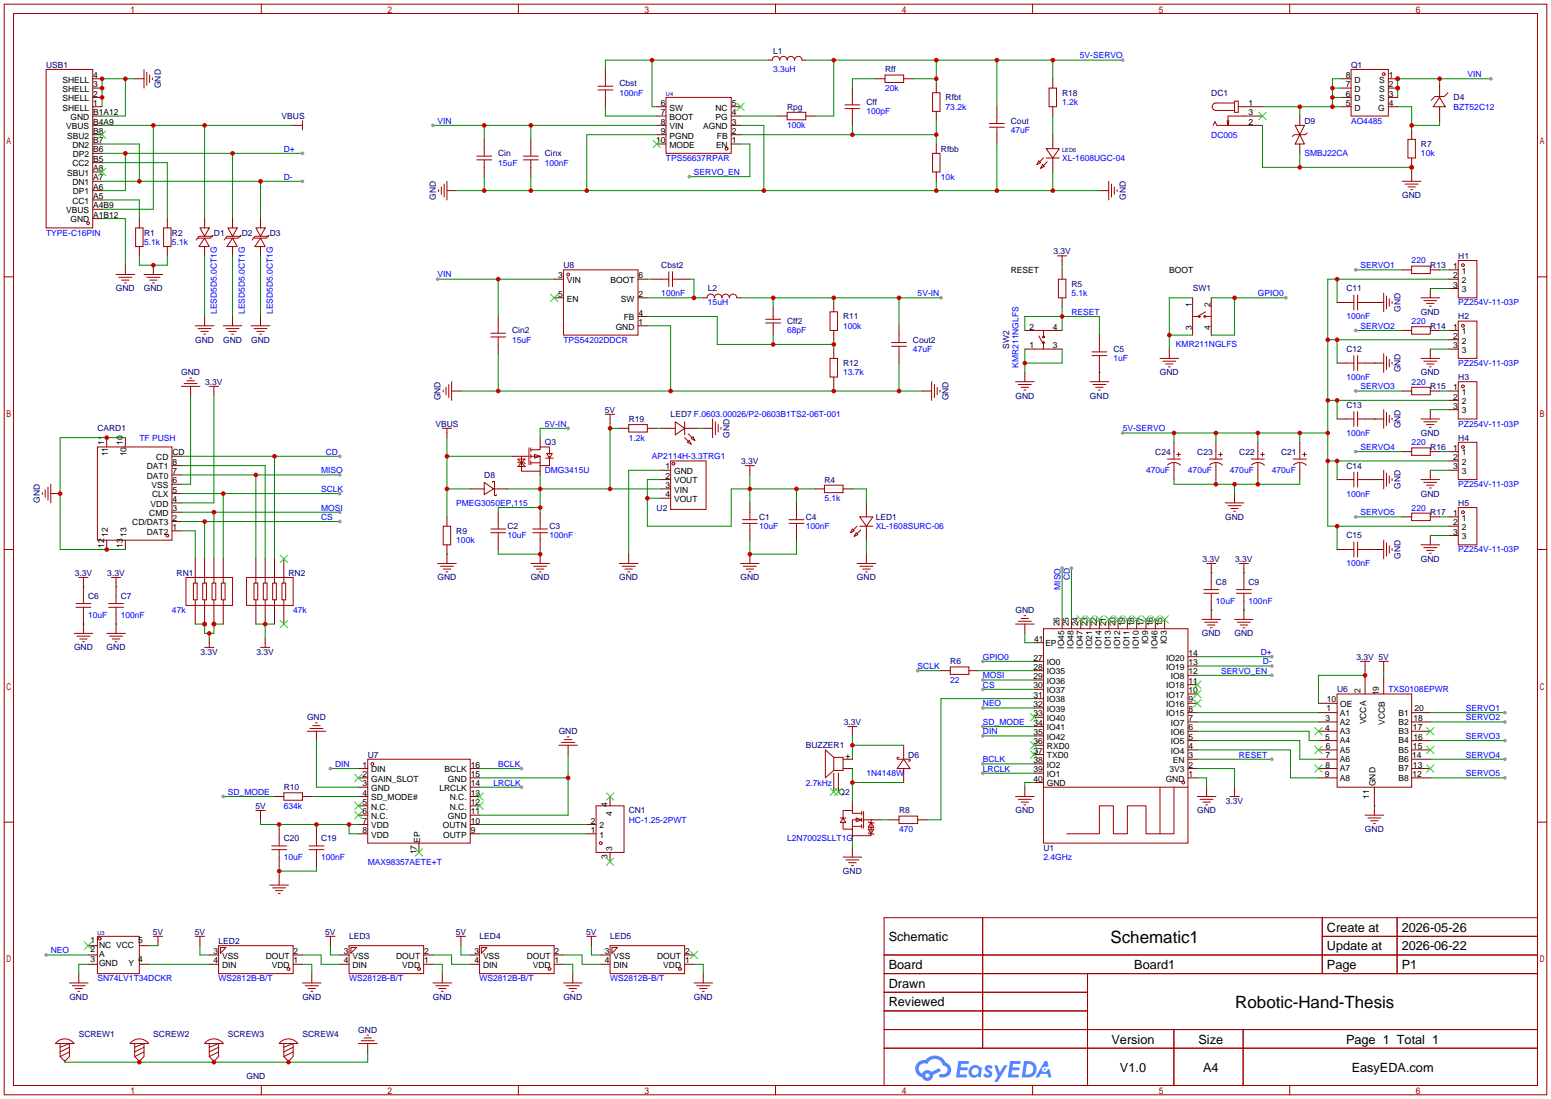
[picture p29: page 1]

GND GND GND GND GND
GND

OUTN 10 GND 11 N.C. 12 N.C. 13 LRCLK 14 GND 15 BCLK 16

Schematic | Schematic1 | Create at | 2026-05-26

Update at | 2026-06-22

Board | Board1 | Page | P1
Drawn | | Robotic-Hand-Thesis
Reviewed

Version | Size | Page 1 Total 1
V1.0 | A4 | EasyEDA.com
